Death6sentence/lm5177-bidirectional-dc-dc-power-supply-150W/docs/images/README.md

# 图片来源与许可证

下表记录 `docs/images/paper/` 中三张论文图片的来源和处理方式。

| 仓库文件 | 来源 | 处理 |
| --- | --- | --- |
| `figure-2-2-power-pcb.png` | `Death6sentence`，论文《基于 LM5177 的双向 DC-DC 电源设计》，原图 2-2 | 从 DOCX 的 `word/media/image8.png` 无损提取，未重绘。 |
| `figure-3-2-control-algorithm-flow.png` | `Death6sentence`，论文《基于 LM5177 的双向 DC-DC 电源设计》，原图 3-2 | 从 DOCX 的 `word/media/image18.png` 无损提取，未重绘。 |
| `figure-3-3-dual-board-collaboration.png` | `Death6sentence`，论文《基于 LM5177 的双向 DC-DC 电源设计》，原图 3-3 | 从 PDF 第 16 页紧密栅格裁剪，排除了页眉、图 3-4 实验照片和周围正文；未重绘内容。 |

`docs/images/paper/` 下的上述三个文件均为依据 CC-BY-SA-4.0 提供的文档资产，属于解释性示意图，不是硬件或性能验证的独立证据。

SPDX-License-Identifier: CC-BY-SA-4.0
SPDX-FileCopyrightText: 2026 LM5177 Power Converter Project Contributors
