Death6sentence/lm5177-bidirectional-dc-dc-power-supply-150W/mechanical/LM5177外壳.png

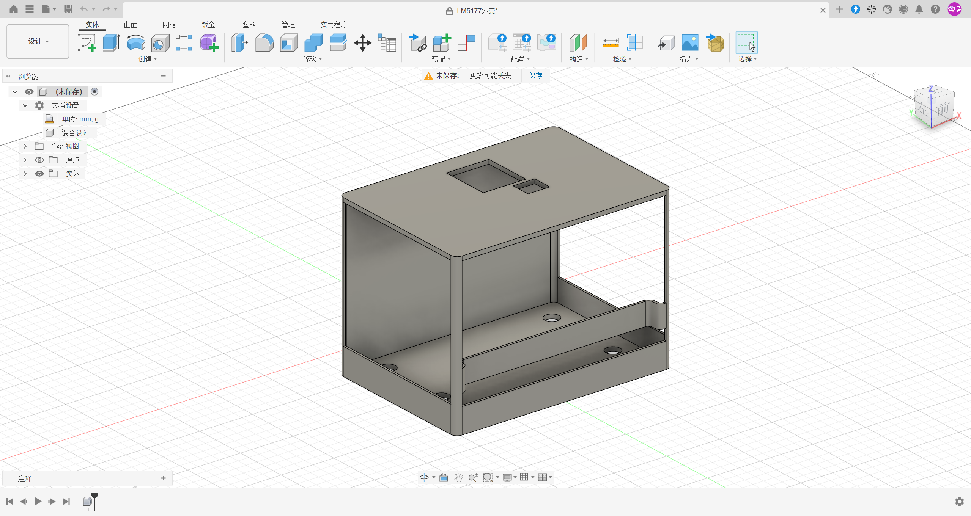
mechanical/LM5177外壳.png
