Death6sentence/lm5177-bidirectional-dc-dc-power-supply-150W/test-data/LM5177_measurements.xlsx

Sheet: README
LM5177 Measurement Data
Item | Description
Scope | Exact sanitized transcription of the project verification record's Chapter 4 measurement tables.
Integrity | No values were synthesized; measured inputs are retained as source values and all derived metrics are formulas.
Recalculation | Formula columns are recalculated in LibreOffice and checked for Excel formula errors.
No-load efficiency | Intentionally blank because the verification record specifies that efficiency is not calculated at no load.
Feedback interpretation | Feedback test values represent the corresponding output voltage, not the controller FB-pin voltage.
Ripple measurement | Output ripple measurements use a 20 MHz bandwidth limit.
License | CC-BY-SA-4.0

Sheet: Test_Conditions
Test Conditions and Central Assumptions
Condition | Value | Unit / meaning
Ambient temperature | 25 | deg C
Relative humidity | 61.0% | %
Board exposure | Uncovered | physical condition
Oscilloscope | 100 MHz, 1 GS/s digital oscilloscope | instrument
Multimeter | 3.5-digit digital multimeter | instrument
Load | Single-phase adjustable resistive load | load equipment
Ripple measurement bandwidth limit | 20 | MHz
Output voltage target | 16 | V
Feedback voltage tolerance | 1.0% | %
Ripple limit | 200 | mVpp
CC setpoint | 1 | A
CC absolute error limit | 0.3 | A
Regulation limit | 1.0% | %

Sheet: Steady_State
Steady-State Measurements
Vin_set (V) | Iout_set (A) | Vin_meas (V) | Iin_meas (A) | Vout_meas (V) | Iout_meas (A) | Reported voltage error (%) | Reported efficiency (%) | Calculated voltage error (%) | Calculated efficiency (%) | Voltage error delta (%) | Efficiency delta (%) | Operating mode
10.000 | 0.000 | 10.060 | 0.102 | 15.960 | 0.000 | -0.250% |  | -0.250% |  | 5.334274689e-15% |  | Boost
10.000 | 1.000 | 10.000 | 1.740 | 15.950 | 1.000 | -0.310% | 91.670% | -0.313% | 91.667% | -0.003% | -0.003% | Boost
10.000 | 3.000 | 9.930 | 5.210 | 15.950 | 3.050 | -0.310% | 94.030% | -0.313% | 94.032% | -0.003% | 0.002% | Boost
16.000 | 0.000 | 16.000 | 0.164 | 15.965 | 0.000 | -0.220% |  | -0.219% |  | 0.001% |  | Equal-voltage
16.000 | 1.000 | 16.000 | 1.201 | 15.970 | 1.000 | -0.190% | 83.110% | -0.187% | 83.108% | 0.003% | -0.002% | Equal-voltage
16.000 | 3.000 | 16.000 | 3.296 | 15.960 | 2.980 | -0.250% | 90.190% | -0.250% | 90.187% | 5.334274689e-15% | -0.003% | Equal-voltage
16.000 | 5.000 | 16.050 | 5.400 | 15.940 | 4.950 | -0.380% | 91.040% | -0.375% | 91.038% | 0.005% | -0.002% | Equal-voltage
30.000 | 0.000 | 30.000 | 0.167 | 15.970 | 0.000 | -0.190% |  | -0.187% |  | 0.003% |  | Buck
30.000 | 1.000 | 30.000 | 0.705 | 15.960 | 1.000 | -0.250% | 75.460% | -0.250% | 75.461% | 5.334274689e-15% | 0.001% | Buck
30.000 | 3.000 | 30.000 | 1.776 | 15.950 | 3.030 | -0.310% | 90.710% | -0.313% | 90.707% | -0.003% | -0.003% | Buck
30.000 | 6.250 | 30.000 | 3.770 | 15.900 | 6.510 | -0.620% | 91.520% | -0.625% | 91.520% | -0.005% | -0.0001061007957% | Buck

Sheet: Voltage_Feedback
Voltage Feedback Verification
Vin_set (V) | Load (A) | Measured output voltage (V) | Reported verdict | Lower limit (V) | Upper limit (V) | Error (%) | Calculated verdict
10.000 | 1.000 | 15.960 | PASS | 15.840 | 16.160 | -0.250% | PASS
16.000 | 1.000 | 15.970 | PASS | 15.840 | 16.160 | -0.187% | PASS
30.000 | 1.000 | 15.960 | PASS | 15.840 | 16.160 | -0.250% | PASS

Sheet: Output_Ripple
Output Ripple Verification
Vin_set (V) | Load (A) | Measured ripple (mVpp) | Reported verdict | Ripple limit (mVpp) | Calculated verdict
10.000 | 1.000 | 122.000 | PASS | 200.000 | PASS
16.000 | 1.000 | 130.000 | PASS | 200.000 | PASS
16.000 | 5.000 | 161.000 | PASS | 200.000 | PASS
30.000 | 1.000 | 44.000 | PASS | 200.000 | PASS
30.000 | 6.250 | 48.000 | PASS | 200.000 | PASS

Sheet: CC_Error
Constant-Current Error Verification
Vin_set (V) | CC_set (A) | Measured absolute error (A) | Reported verdict | Absolute error limit (A) | Calculated verdict
10.000 | 1.000 | 0.120 | PASS | 0.300 | PASS
16.000 | 1.000 | 0.160 | PASS | 0.300 | PASS
30.000 | 1.000 | 0.090 | PASS | 0.300 | PASS

Sheet: Regulation
Load and Line Regulation
Metric | Vin / comparison (V) | Load / comparison (A) | Reported value (%) | Formula value (%) | Delta (%) | Limit (%) | Reported verdict | Calculated verdict
Load regulation | 10 | 0 to 3 | 0.063% | 0.063% | -0.0005% | 1.000% | PASS | PASS
Load regulation | 16 | 0 to 5 | 0.156% | 0.156% | 0.00025% | 1.000% | PASS | PASS
Load regulation | 30 | 0 to 6.25 | 0.438% | 0.438% | -0.0005% | 1.000% | PASS | PASS
Line regulation | 10, 16, 30 | 1 fixed | 0.125% | 0.125% | 8.435092902e-15% | 1.000% | PASS | PASS
Line regulation | 10, 16, 30 | 3 fixed | 0.063% | 0.063% | -0.0005% | 1.000% | PASS | PASS

Sheet: Data_Dictionary
Data Dictionary
Dataset | Column | Unit | Status | Source / formula meaning
Test_Conditions | Condition | text | Hardcoded condition | Condition or central assumption label.
Test_Conditions | Value | varies | Hardcoded source value | Centralized test condition or assumption used by formulas.
Test_Conditions | Unit / meaning | text | Hardcoded metadata | Unit or physical meaning of the condition.
Steady_State | Vin_set | V | Raw measured input | Set input voltage from Table 4-1.
Steady_State | Iout_set | A | Raw measured input | Set output current from Table 4-1.
Steady_State | Vin_meas | V | Raw measured input | Measured input voltage from Table 4-1.
Steady_State | Iin_meas | A | Raw measured input | Measured input current from Table 4-1.
Steady_State | Vout_meas | V | Raw measured input | Measured output voltage from Table 4-1.
Steady_State | Iout_meas | A | Raw measured input | Measured output current from Table 4-1.
Steady_State | Reported voltage error | % | Raw reported input | Reported percentage stored as an Excel decimal percentage.
Steady_State | Reported efficiency | % | Raw reported input | Reported percentage stored as an Excel decimal percentage; blank at no load.
Steady_State | Calculated voltage error | % | Formula | (Vout_meas - target voltage) / target voltage.
Steady_State | Calculated efficiency | % | Formula | Blank at zero measured output current; otherwise (Vout_meas * Iout_meas) / (Vin_meas * Iin_meas).
Steady_State | Voltage error delta | % | Formula | Calculated voltage error minus reported voltage error.
Steady_State | Efficiency delta | % | Formula | Calculated efficiency minus reported efficiency; blank at no load.
Steady_State | Operating mode | text | Formula | Boost when Vin setpoint is below target, Equal-voltage at target, otherwise Buck.
Voltage_Feedback | Vin_set | V | Raw measured input | Set input voltage from Table 4-2.
Voltage_Feedback | Load | A | Raw measured input | Load current from Table 4-2.
Voltage_Feedback | Measured output voltage | V | Raw measured input | Feedback-corresponding output voltage, not controller FB-pin voltage.
Voltage_Feedback | Reported verdict | text | Raw reported input | Reported pass/fail verdict from Table 4-2.
Voltage_Feedback | Lower limit | V | Formula | Target voltage multiplied by 1 minus feedback tolerance.
Voltage_Feedback | Upper limit | V | Formula | Target voltage multiplied by 1 plus feedback tolerance.
Voltage_Feedback | Error | % | Formula | Measured output voltage minus target, divided by target.
Voltage_Feedback | Calculated verdict | text | Formula | PASS when measured voltage is within the formula lower and upper limits.
Output_Ripple | Vin_set | V | Raw measured input | Set input voltage from Table 4-2.
Output_Ripple | Load | A | Raw measured input | Load current from Table 4-2.
Output_Ripple | Measured ripple | mVpp | Raw measured input | Measured output ripple using the 20 MHz bandwidth limit.
Output_Ripple | Reported verdict | text | Raw reported input | Reported pass/fail verdict from Table 4-2.
Output_Ripple | Ripple limit | mVpp | Formula | Central ripple limit from Test_Conditions.
Output_Ripple | Calculated verdict | text | Formula | PASS when measured ripple is at or below the central ripple limit.
CC_Error | Vin_set | V | Raw measured input | Set input voltage from Table 4-3.
CC_Error | CC_set | A | Raw measured input | Constant-current setpoint from Table 4-3.
CC_Error | Measured absolute error | A | Raw measured input | Absolute deviation from the 1 A CC setpoint, not actual output current.
CC_Error | Reported verdict | text | Raw reported input | Reported pass/fail verdict from Table 4-3.
CC_Error | Absolute error limit | A | Formula | Central CC absolute error limit from Test_Conditions.
CC_Error | Calculated verdict | text | Formula | PASS when measured absolute error is at or below the central CC limit.
Regulation | Metric | text | Raw reported input | Load regulation or line regulation metric from Table 4-4.
Regulation | Vin / comparison | V | Raw reported input | Input voltage or voltage comparison set from Table 4-4.
Regulation | Load / comparison | A | Raw reported input | Load current range or fixed current from Table 4-4.
Regulation | Reported value | % | Raw reported input | Published Table 4-4 percentage stored as an Excel decimal percentage.
Regulation | Formula value | % | Formula | Load regulation uses absolute endpoint Vout difference / target; line regulation uses (max Vout - min Vout) / target.
Regulation | Delta | % | Formula | Formula value minus reported value.
Regulation | Limit | % | Formula | Central regulation limit from Test_Conditions.
Regulation | Reported verdict | text | Raw reported input | Reported pass/fail verdict from Table 4-4.
Regulation | Calculated verdict | text | Formula | PASS when formula value is at or below the central regulation limit.

Sheet: Provenance
Provenance and License
Field | Value
Source | Sanitized project verification record, Chapter 4 tables 4-1 through 4-4
Extraction date | 2026-10-19
Source retention | Source retained privately outside this release
Metadata handling | Identity/document metadata was intentionally omitted
SPDX identifier | CC-BY-SA-4.0
Attribution | LM5177 Power Converter Project Contributors
