Death6sentence/lm5177-bidirectional-dc-dc-power-supply-150W/mechanical/LM5177外壳.step

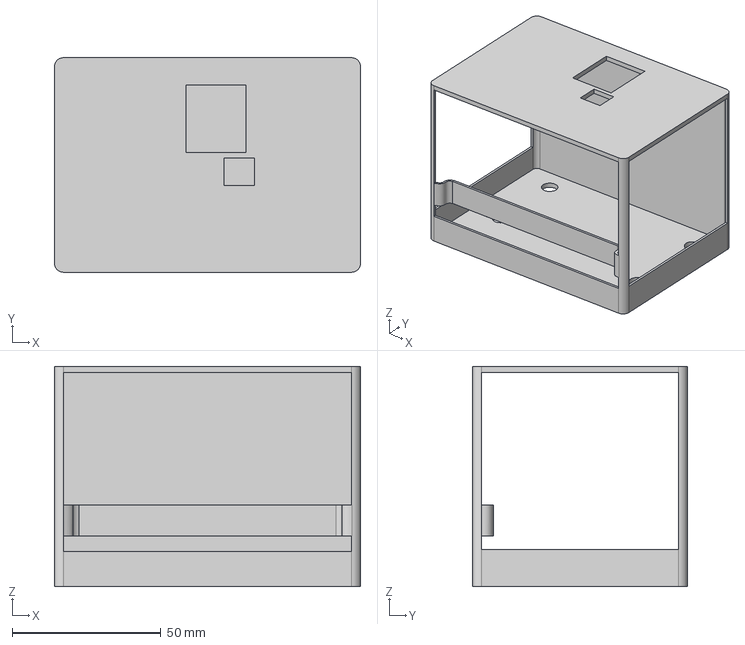
[picture p6: CAD file, 2026-10-19]
mechanical/LM5177外壳.step
102.8 x 72.1 x 74.0 mm
