Death6sentence/lm5177-bidirectional-dc-dc-power-supply-150W/(list of files, cad)

Other CAD files:
mechanical/LM5177外壳.obj
