Death6sentence/lm5177-bidirectional-dc-dc-power-supply-150W/docs/verification/release-checklist.md

# 发布清单

## 本次发布已完成

- 选定并记录本次发布的源文件产物。
- 排除生成文件、缓存、日志、预览和个人路径材料。
- 对发布材料执行面向隐私的扫描。
- 在保持 PCB 字节数不变的前提下替换路径，并记录哈希值和字节差异范围。
- 确认机械发布文件与选定的源文件产物逐字节一致。
- 记录字体来源和固定的上游提交。
- 执行固件源代码级基本编译检查；该检查不是 Keil 目标构建，也未验证固件烧录或目标运行。
- 执行工作簿静态检查：9 个工作表、103 个公式、全部 103 个公式单元格都有序列化缓存节点、97 个非空缓存节点、6 个有意的空字符串结果、8 个 Tables，且有 0 个外部链接。
- 使用 Excel 16 以只读方式成功打开工作簿；这仅验证了工作簿的可读性和兼容性，不代表测量准确性或公式适用性。

## 本次发布准备未完成

- Keil 目标构建或固件烧录。
- 目标硬件运行或台架验证。
- Altium 项目编译、ERC、DRC 或输出生成。
- 机械装配、容差或制造验证。

未完成的检查需要相应的厂商工具、硬件或实体检查。由于这些检查尚未完成，本次发布属于源文件和参考资料发布，不构成认证或生产就绪声明。

SPDX-License-Identifier: CC-BY-SA-4.0

SPDX-FileCopyrightText: 2026 LM5177 Power Converter Project Contributors
