Death6sentence/lm5177-bidirectional-dc-dc-power-supply-150W/(list of files, drawings)

Other design files:
hardware/altium/BMC096C.schdoc
hardware/altium/Copy of ASCIIPCB2.pcbdoc
hardware/altium/PCB_Project1.PrjPCB
